KUBTSSAvionics/PitotBoard2026/PitotBoard2026/3dmodels/BME280.step

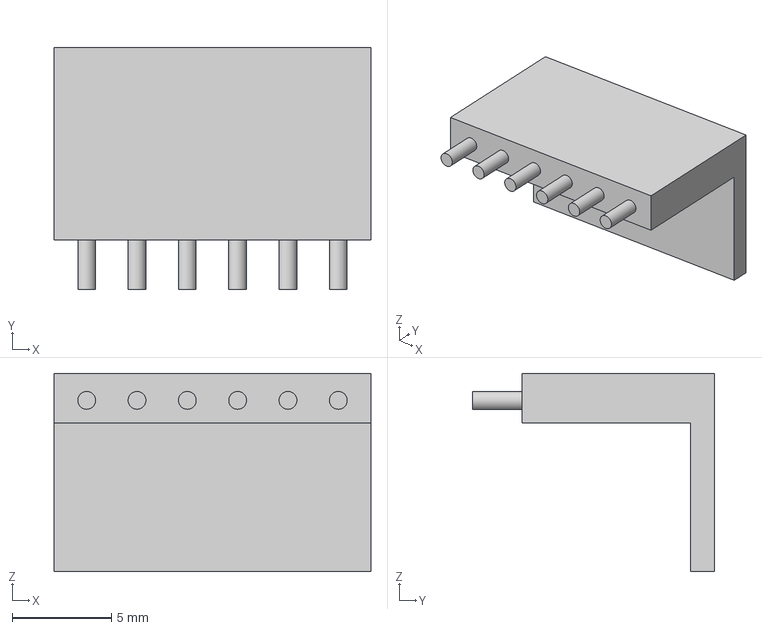
[picture p1: CAD file, 2026-03-10]
PitotBoard2026/3dmodels/BME280.step
16.0 x 12.2 x 10.0 mm
