KUBTSSAvionics/PitotBoard2026/PitotBoard2026/3dmodels/SDP32-125PA-TR-250PCS.STEP

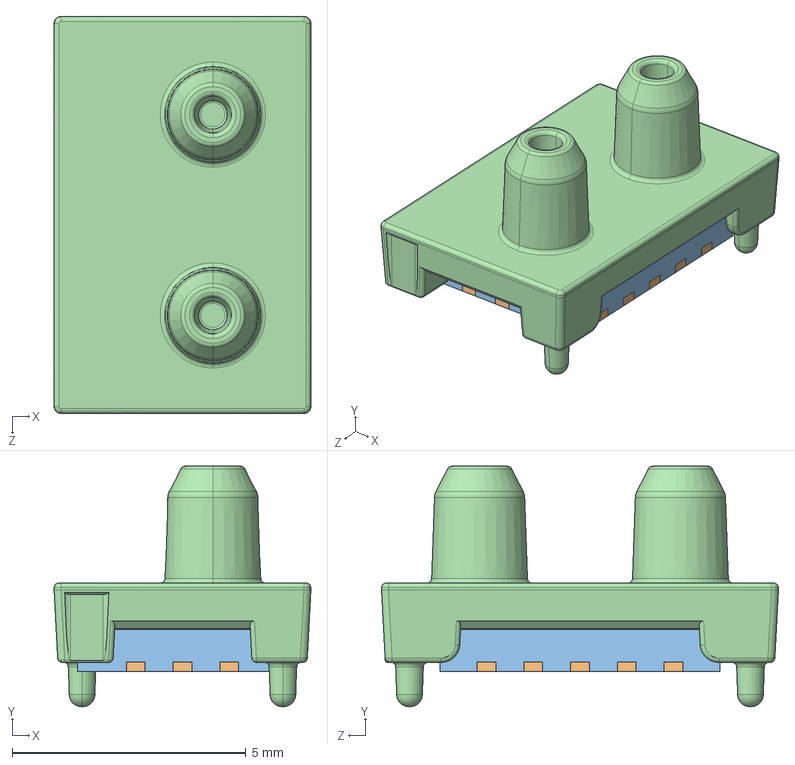
[picture p2: CAD file, 2026-03-10]
PitotBoard2026/3dmodels/SDP32-125PA-TR-250PCS.STEP
5.50 x 5.15 x 8.50 mm
