KUBTSSAvionics/PitotBoard2026/PitotBoard2026/3dmodels/Modular_jack.step

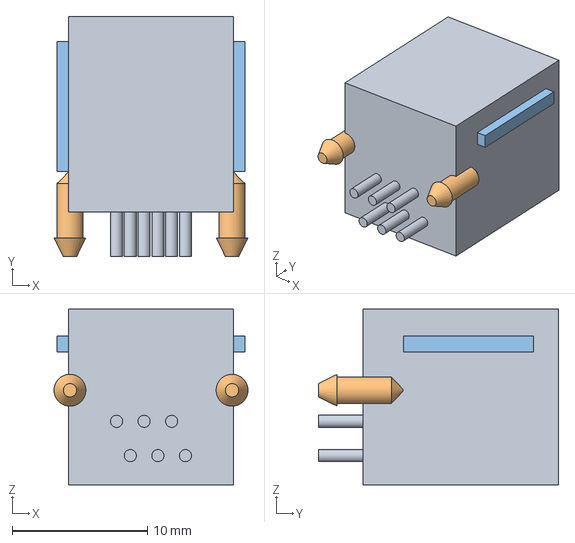
[picture p3: CAD file, 2026-03-10]
PitotBoard2026/3dmodels/Modular_jack.step
14.4 x 17.8 x 13.0 mm
