KUBTSSAvionics/PitotBoard2026/PitotBoard2026/3dmodels/SKRPAC.STEP

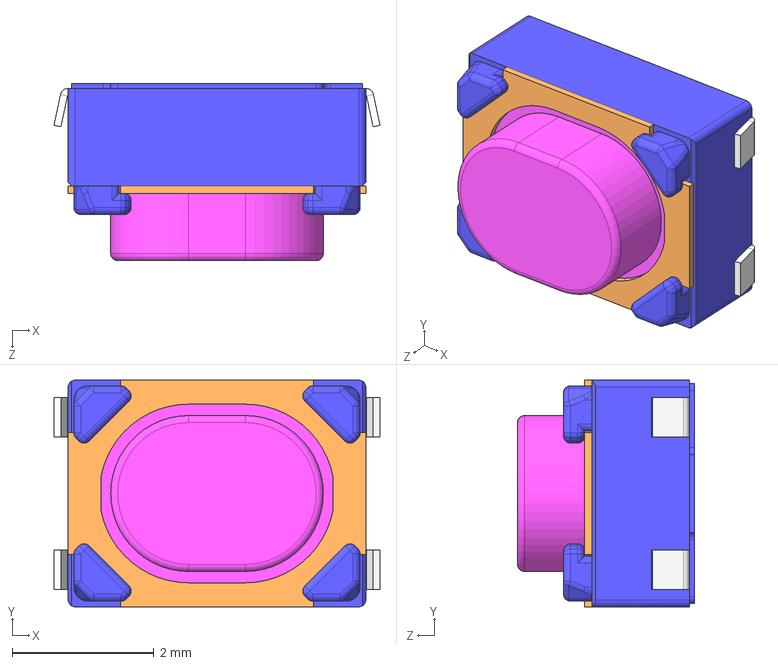
[picture p4: CAD file, 2026-03-10]
PitotBoard2026/3dmodels/SKRPAC.STEP
4.60 x 3.20 x 2.50 mm
