KUBTSSAvionics/PitotBoard2026/PitotBoard2026/3dmodels/DFE322512F-100M=P2.STEP

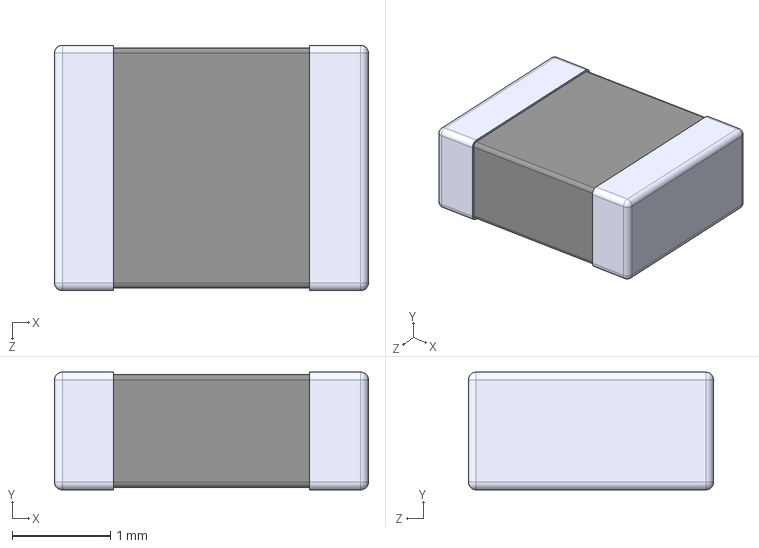
[picture p5: CAD file, 2026-03-10]
PitotBoard2026/3dmodels/DFE322512F-100M=P2.STEP
3.20 x 1.20 x 2.50 mm
