KUBTSSAvionics/PitotBoard2026/(commit log)

2025-10-09 Add files via upload
    試作前完成版 FXMA2102配置
    [PitoBoard2026.kicad_pcb, PitoBoard2026.kicad_sch]
2025-11-06 Add files via upload
    SDP32を配置
    [PitoBoard2026.kicad_sch]
2025-11-15 Add files via upload
    フットプリント設定完了
    [PitoBoard2026.kicad_pcb, PitoBoard2026.kicad_sch]
2025-11-15 I2Cのエラーを修正
    5Vを3.3Vの方につないでいたのを修正
    [PitoBoard2026.kicad_sch]
2025-11-15 5Vと3.3Vのミスを修正
    [PitoBoard2026.kicad_pcb, PitoBoard2026.kicad_sch]
2025-11-17 配線終わり(部品は違う)
    [PitoBoard2026.kicad_pcb, PitoBoard2026.kicad_sch]
2025-11-17 Add files via upload
    レギュレータ変更。PCBエディターは配線前にリセットした。
    [PitoBoard2026.kicad_pcb, PitoBoard2026.kicad_sch]
2025-11-17 Add files via upload
    Edge Cuts消去
    [PitoBoard2026.kicad_pcb]
2026-02-13 Add files via upload
    入江さんのフィードバックを回路図に反映
    [PitoBoard2026.kicad_pcb, PitoBoard2026.kicad_sch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]
2026-03-09 Add files via upload
    ガーバーファイル作成
    [PitotBoard2026-B_Cu.gbl, PitotBoard2026-B_Mask.gbs, PitotBoard2026-B_Paste.gbp, PitotBoard2026-B_Silkscreen.gbo, PitotBoard2026-Edge_Cuts.gm1, PitotBoard2026-F_Cu.gtl, PitotBoard2026-F_Mask.gts, PitotBoard2026-F_Paste.gtp]
2026-04-29 Add files via upload
    FXMA2102とM78ARのフットプリントを修正
    [PitotBoard2026-B_Cu.gbl, PitotBoard2026-B_Mask.gbs, PitotBoard2026-B_Paste.gbp, PitotBoard2026-B_Silkscreen.gbo, PitotBoard2026-Edge_Cuts.gm1, PitotBoard2026-F_Cu.gtl, PitotBoard2026-F_Mask.gts, PitotBoard2026-F_Paste.gtp]
2026-05-27 Add files via upload
    MCP25625を5Vに変更。FXMA2102のピン番号を修正。
    [PitotBoard2026-B_Cu.gbl, PitotBoard2026-B_Mask.gbs, PitotBoard2026-B_Paste.gbp, PitotBoard2026-B_Silkscreen.gbo, PitotBoard2026-Edge_Cuts.gm1, PitotBoard2026-F_Cu.gtl, PitotBoard2026-F_Mask.gts, PitotBoard2026-F_Paste.gtp]
